rocknRol/max7219mat/electronic circuit board/max7219mat_board.kicad_pcb

## KiCad design Atmel.sch

Schematic: Atmel.sch

Parts:
C1, C3: 1uF; C_0603_HandSoldering
C2, C4, C5, C6, C7, C8, C9, C12: 0.1uF; DigiKeyPN 732-8422-1-ND
C10: 1.0uF; DigiKeyPN 732-8422-1-ND
C11, C13: 18pF; DigiKeyPN 732-8422-1-ND
J1: CONN_01X08
J2: CONN_01X06
R1, R2, R3, R4: 4.7K; R_0603_HandSoldering
R5, R6, R7, R8, R9: 0R0
R10: 1K
SW1: SW_Push
TP1, TP2, TP3, TP4, TP5: TEST; Measurement_Point_Round-TH_Small
U1: PCA9306; SSOP-8_2.95x2.8mm_Pitch0.65mm; DigiKeyPN 296-39140-1-ND
U2: ATMEGA328P-AU; TQFP32
U3: DS1339
Y1: 32.768kHz
Y2: 8MHz
