rocknRol/max7219mat/electronic circuit board/max7219mat_board.kicad_pcb

## KiCad design Tube.sch

Schematic: Tube.sch

Parts:
J5, J6, J7, J8, J9, J10, J11, J12, J13, J14, J15, J16, J17, J18, J19, J20, J21, J22, J23: TEST_1P
R21, R23, R24: 0R0
R22, R25: 84.5K
U7, U8, U9, U10: TPIC6B595
V1, V2: IN-12A

Notes on the sheet:
SECONDS: TENS
SECONDS: ONES
