rocknRol/max7219mat/(commit log)

2021-06-07 addition electronic circuit board files
    [max7219mat_board.kicad_pcb, max7219mat_board.sch]
2021-06-28 addition driver source code
